ManiacalLabs/AllPixel/ATMega32U4_Arduino_Core/README.md

ATUSB_Core
==========

Modified Arduino Core for ATMega32u4 based on the Teensy core.

Designed for use with the [AllPixel](http://maniacallabs.com/AllPixel). 

Allows for full USB 1.1 speed (12Mbps) when using USB CDC Serial communications.

Currently, there is no functional bootloader for use with this core. An ICSP programmer is required for upload of any code.
