ManiacalLabs/AllPixel/Case/AllPixelCaseBottom.stl

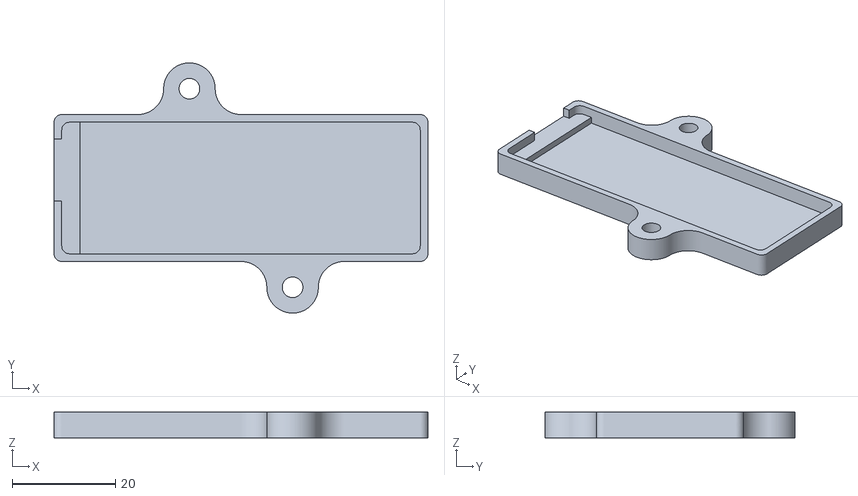
[picture p1: CAD file, 2015-03-14]
Case/AllPixelCaseBottom.stl
72.5 x 48.5 x 5.00
