ManiacalLabs/AllPixel/TinyTiMAllPixelStand/TinyTiMAPStand_noslot.stl

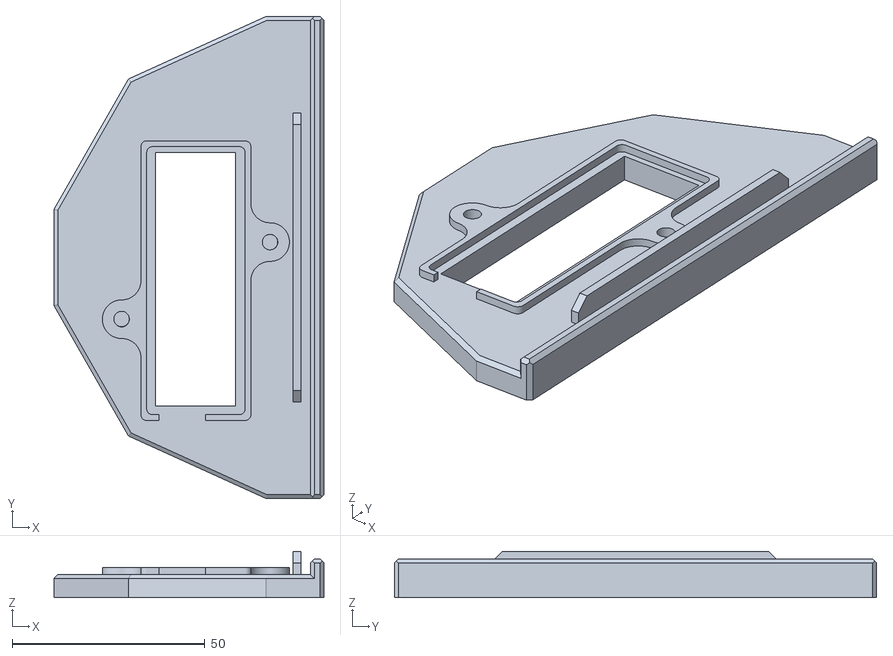
[picture p2: CAD file, 2015-03-22]
TinyTiMAllPixelStand/TinyTiMAPStand_noslot.stl
70.0 x 125.0 x 12.0
