ManiacalLabs/AllPixel/Case/AllPixelCaseTop.stl

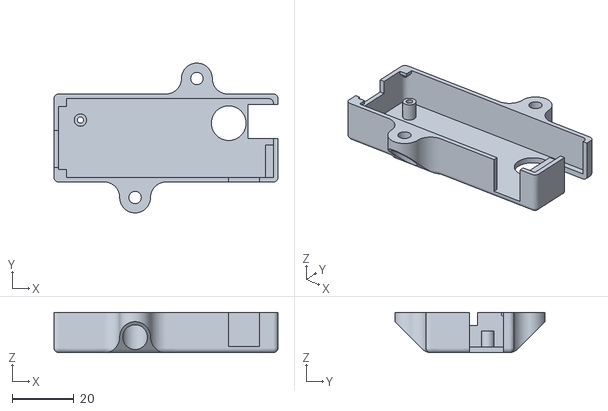
[picture p3: CAD file, 2015-03-14]
Case/AllPixelCaseTop.stl
72.5 x 48.5 x 13.0
