ManiacalLabs/AllPixel/Case/AllPixelCaseTop_NoCapHole.stl

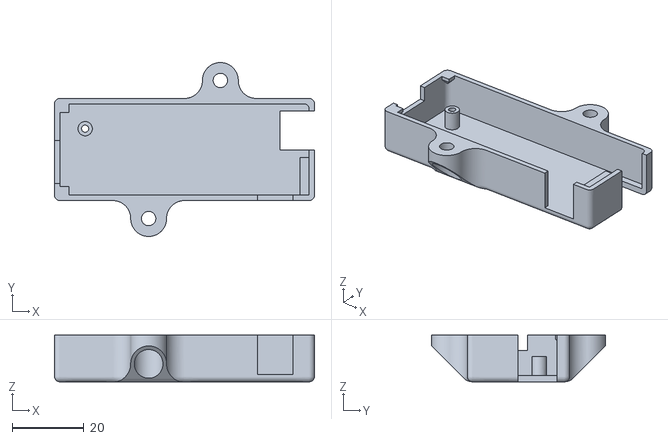
[picture p4: CAD file, 2015-03-14]
Case/AllPixelCaseTop_NoCapHole.stl
72.5 x 48.5 x 13.0
