ManiacalLabs/AllPixel/PCB/AllPixel/AllPixel.pdf

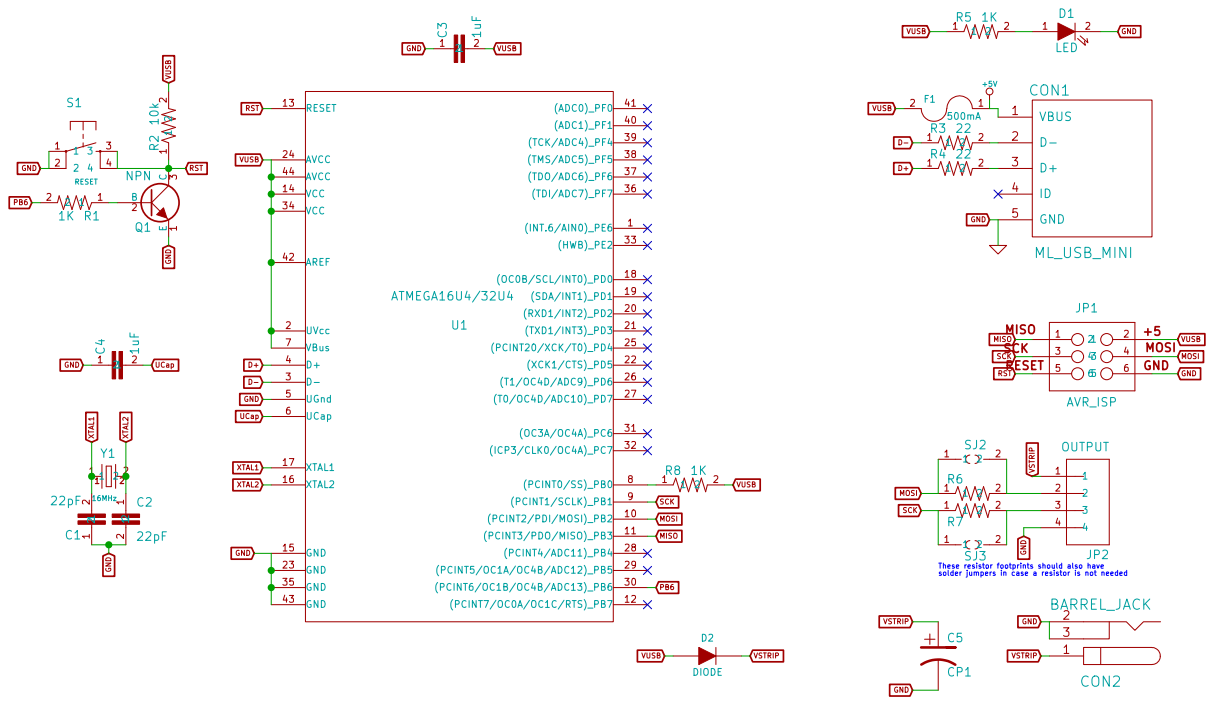
[picture p5: page 1]

These resistor footprints should also have

Id: 1/1 Title: File: AllPixel.sch Sheet: /
