ManiacalLabs/AllPixel/(list of files, drawings)

Other design files:
PCB/AllPixel/AllPixel.dsn
