ManiacalLabs/AllPixel/PCB/AllPixel/PowerTap.kicad_pcb

## KiCad design PCB/AllPixel/PowerTap.kicad_pcb (2015-01-11)

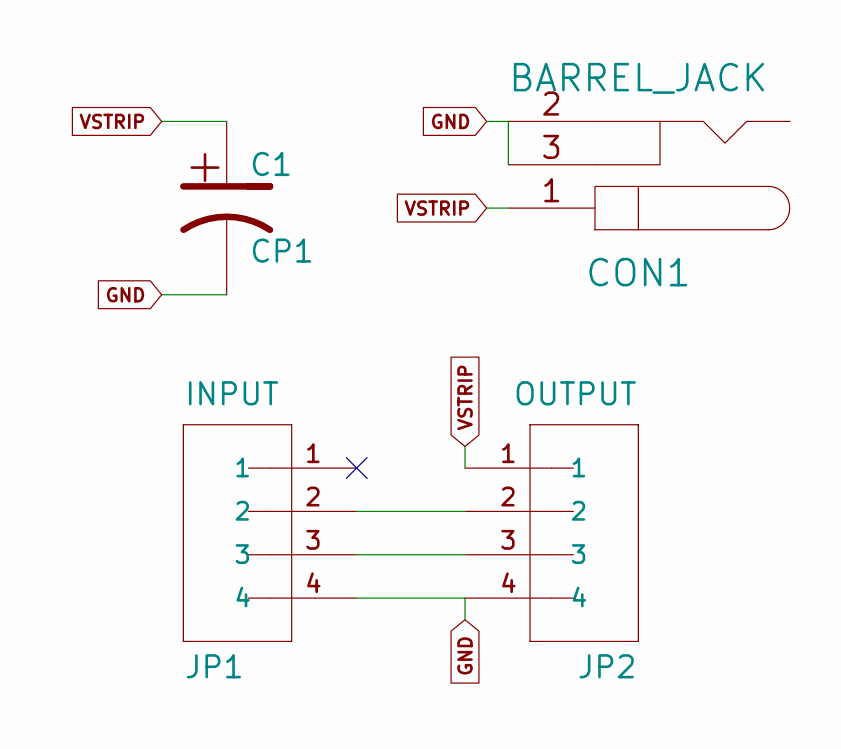
[picture p6: schematic PowerTap.sch]

Parts:
C1: CP1
CON1: BARREL_JACK
JP1: INPUT; SparkFun-1X04_LOCK
JP2: OUTPUT; SparkFun-1X04_LOCK

Connections:
GND: C1.2, CON1.2, CON1.3, JP1.4, JP2.4
unnamed: JP1.2, JP2.2
unnamed: JP1.3, JP2.3
VSTRIP: C1.1, CON1.1, JP2.1

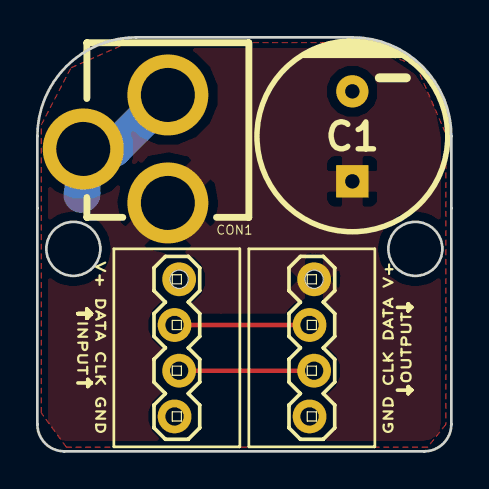
[picture p7: board PowerTap.kicad_pcb from above]

Board: 2 copper layers, 23.0 x 23.0 mm, 4 parts (0 on the bottom side), 4 nets.
