ManiacalLabs/AllPixel/PCB/AllPixelMini/TestJig/PCB/APMTestJig.kicad_pcb

## KiCad design PCB/AllPixelMini/TestJig/PCB/APMTestJig.kicad_pcb (2017-06-18)

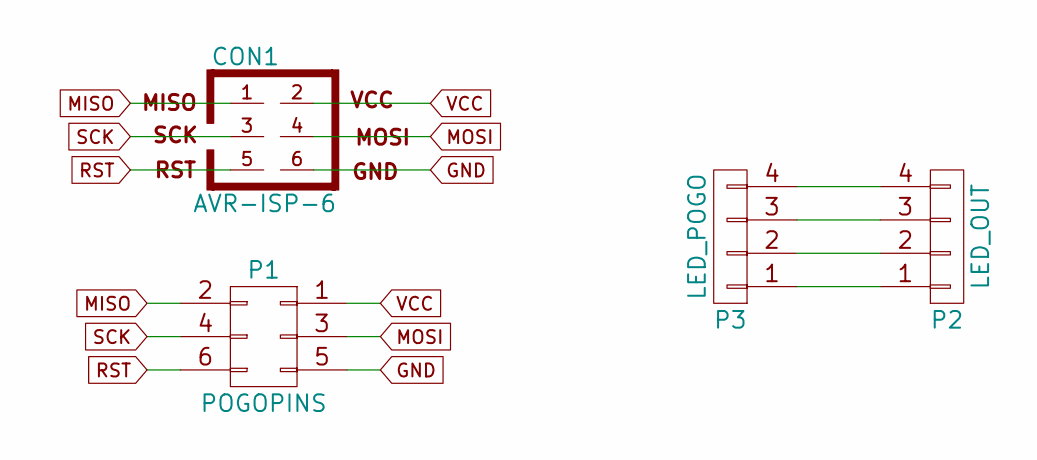
[picture p8: schematic APMTestJig.sch]

Parts:
CON1: AVR-ISP-6; ICSP_1mm097Drill
P1: POGOPINS; ICSP_1mm097Drill
P2: LED_OUT; TerminalBlock_Pheonix_MPT-2.54mm_4pol
P3: LED_POGO; 1x4_1mm097Drill

Connections:
GND: CON1.6, P1.5
MISO: CON1.1, P1.2
MOSI: CON1.4, P1.3
unnamed: P2.1, P3.1
unnamed: P2.2, P3.2
unnamed: P2.3, P3.3
unnamed: P2.4, P3.4
RST: CON1.5, P1.6
SCK: CON1.3, P1.4
VCC: CON1.2, P1.1

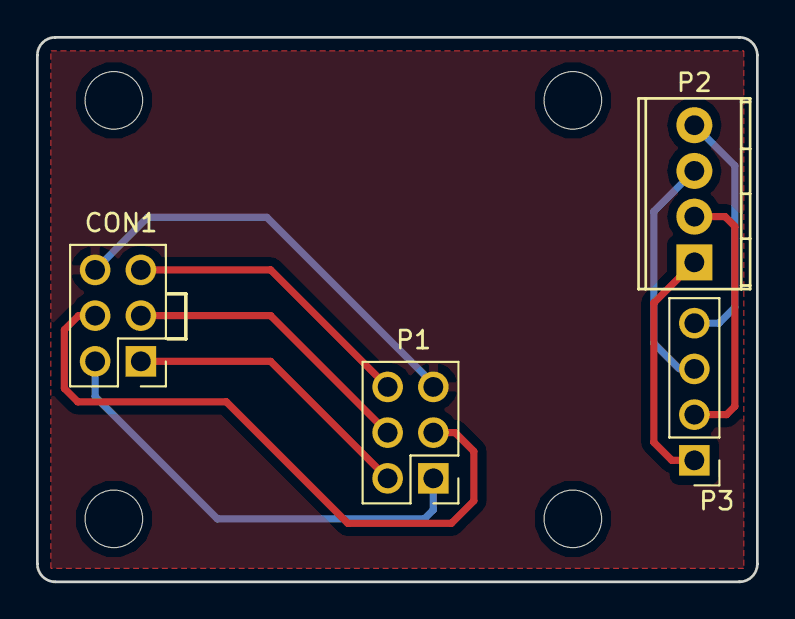
[picture p9: board APMTestJig.kicad_pcb from above]

Board: 2 copper layers, 40.0 x 30.2 mm, 4 parts (0 on the bottom side), 10 nets.
