ManiacalLabs/AllPixel/PCB/AllPixel/AllPixel.kicad_pcb

## KiCad design PCB/AllPixel/AllPixel.kicad_pcb (2015-01-11)

Schematic: AllPixel.sch

Parts:
C1, C2: 22pF; AXIAL-5MM
C3, C4: 1uF; AXIAL-5MM
C5: CP1
CON1: ML_USB_MINI
CON2: BARREL_JACK
D1: LED
D2: DIODE
F1: 500mA
JP1: AVR_ISP; SparkFun-2X3_LOCK
JP2: OUTPUT; SparkFun-1X04_LOCK
Q1: NPN
R1, R5, R8: 1K; R-AXIAL-0.4
R2: 10k; R-AXIAL-0.4
R3, R4: 22; R-AXIAL-0.4
R6, R7: OPT; R-AXIAL-0.4
S1: RESET; SparkFun-TACTILE-PTH
SJ2, SJ3: SOLDERJUMPERNO; SparkFun-SJ_2S-NO
U1: ATMEGA16U4/32U4
Y1: 16MHz; SparkFun-HC49US

Connections:
+5V: CON1.1 (VBUS), F1.1
D+: R4.1, U1.4 (D+)
D-: R3.1, U1.3 (D-)
GND: C1.1, C2.2, C3.1, C4.1, C5.2, CON1.5 (GND), CON2.2, CON2.3, D1.2 (K), JP1.6, JP2.4, Q1.1 (E), S1.1, S1.2, U1.5 (UGnd), U1.15 (GND), U1.23 (GND), U1.35 (GND), U1.43 (GND)
MISO: JP1.1, U1.11 ((PCINT3/PDO/MISO)_PB3)
MOSI: JP1.4, R6.1, SJ2.1, U1.10 ((PCINT2/PDI/MOSI)_PB2)
unnamed: D1.1 (A), R5.2
unnamed: CON1.2 (D-), R3.2
unnamed: CON1.3 (D+), R4.2
unnamed: Q1.2 (B), R1.1
unnamed: JP2.3, R7.2, SJ3.2
unnamed: JP2.2, R6.2, SJ2.2
unnamed: R8.1, U1.8 ((PCINT0/SS)_PB0)
PB6: R1.2, U1.30 ((PCINT6/OC1B/OC4B/ADC13)_PB6)
RST: JP1.5, Q1.3 (C), R2.1, S1.3, S1.4, U1.13 (RESET)
SCK: JP1.3, R7.1, SJ3.1, U1.9 ((PCINT1/SCLK)_PB1)
UCap: C4.2, U1.6 (UCap)
VSTRIP: C5.1, CON2.1, D2.2 (K), JP2.1
VUSB: C3.2, D2.1 (A), F1.2, JP1.2, R2.2, R5.1, R8.2, U1.2 (UVcc), U1.7 (VBus), U1.14 (VCC), U1.24 (AVCC), U1.34 (VCC), U1.42 (AREF), U1.44 (AVCC)
XTAL1: C1.2, U1.17 (XTAL1), Y1.1
XTAL2: C2.1, U1.16 (XTAL2), Y1.2

Notes on the sheet:
These resistor footprints should also have solder jumpers in case a resistor is not needed

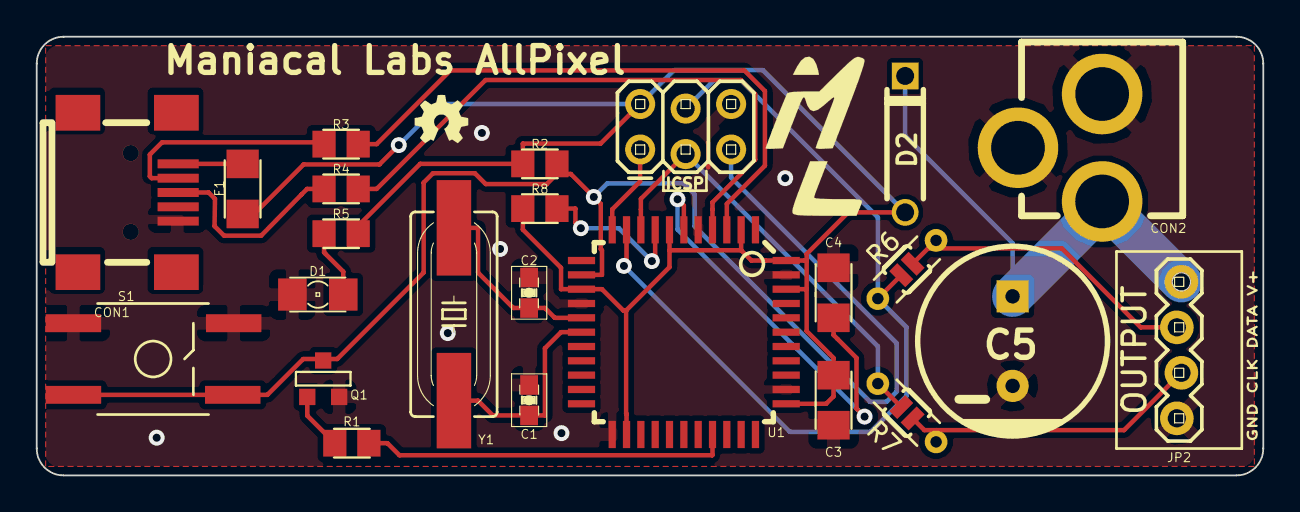
[picture p10: board AllPixel.kicad_pcb from above]

Board: 2 copper layers, 68.5 x 24.5 mm, 27 parts (0 on the bottom side), 21 nets.

Other parts of the board:
Ref**: Val**; ML_LOGO
