ManiacalLabs/AllPixel/PCB/AllPixelMini/PCB/APmini.kicad_pcb

## KiCad design PCB/AllPixelMini/PCB/APmini.kicad_pcb (2017-06-18)

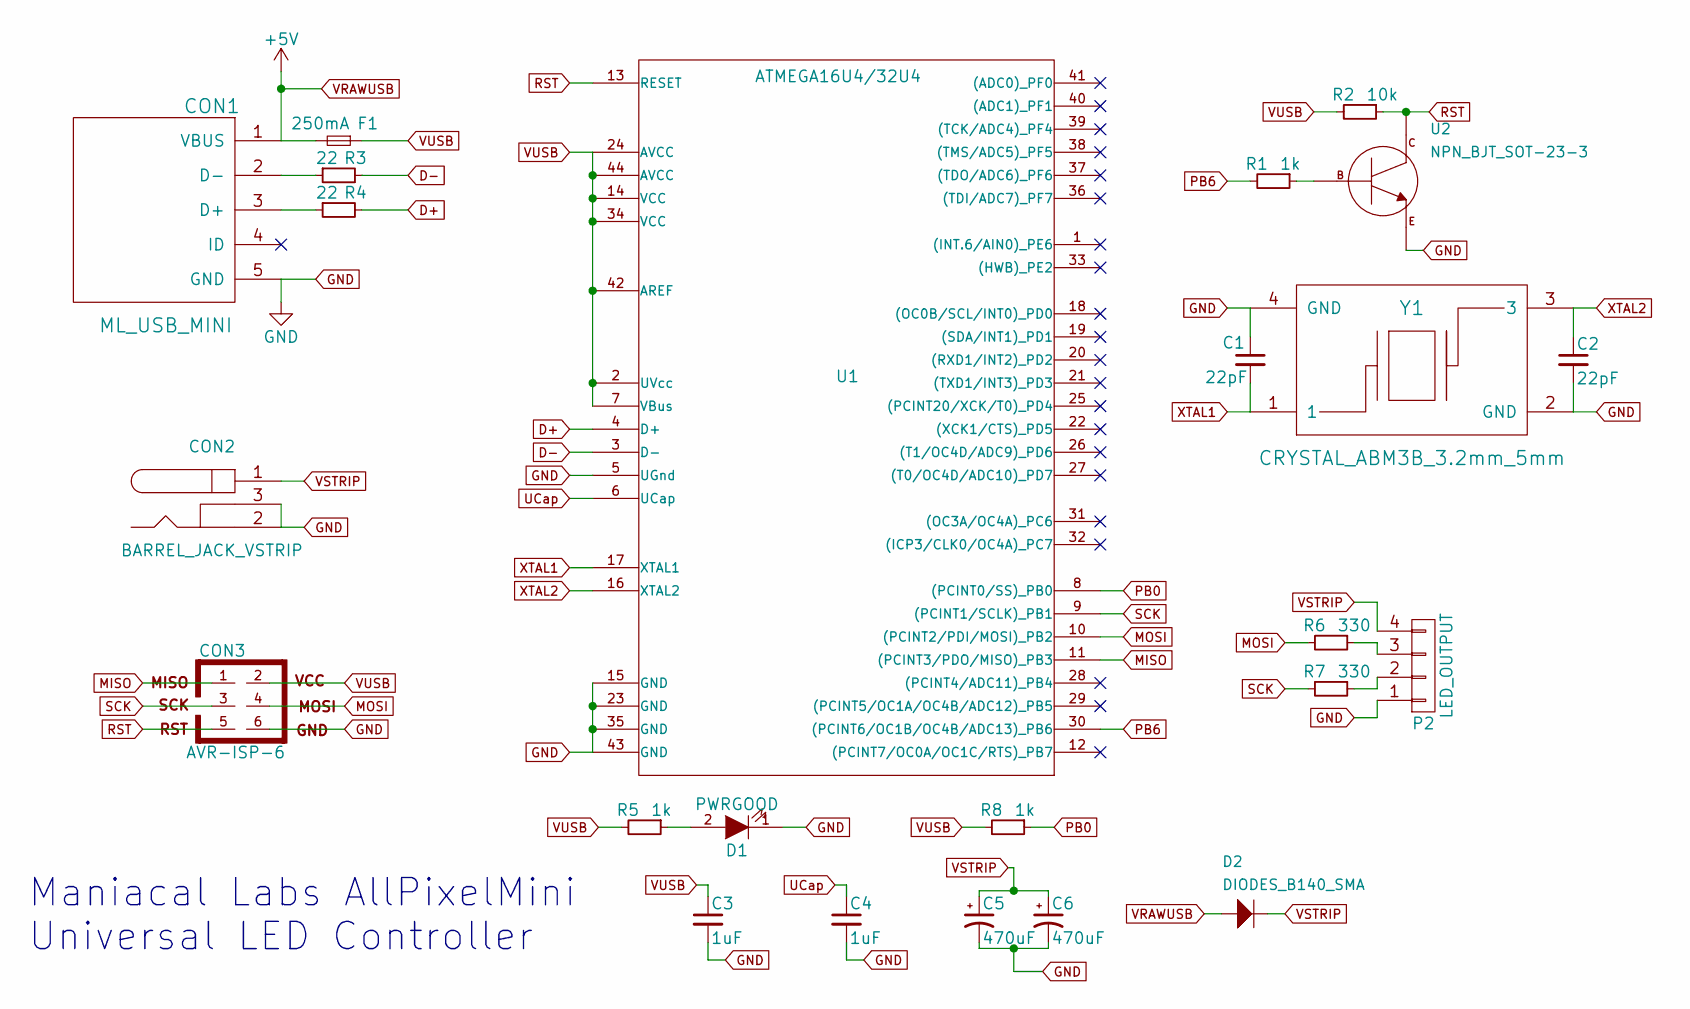
[picture p11: schematic APmini.sch, AllPixelMini]

Parts:
C1, C2: 22pF; C_0603
C3, C4: 1uF; C_0603
C5, C6: 470uF; c_elec_10x10
CON1: ML_USB_MINI; MF_Connectors-MICROUSB-RIGHT
CON2: BARREL_JACK_VSTRIP; ML_BARREL_JACK_ROUND_PADS_SHORT
CON3: AVR-ISP-6; ML_ICSP_PADS
D1: PWRGOOD; LED_0603
D2: DIODES_B140_SMA; MF_Discrete_Semiconductor-SMA
F1: 250mA; C_1206
P2: LED_OUTPUT; TerminalBlock_Pheonix_MPT-2.54mm_4pol
R1, R5, R8: 1k; 0603R_dist_m635
R2: 10k; 0603R_dist_m635
R3, R4: 22; 0603R_dist_m635
R6, R7: 330; 0603R_dist_m635
U1: ATMEGA16U4/32U4; TQFP-44_10x10mm_Pitch0.8mm
U2: NPN_BJT_SOT-23-3; MF_Discrete_Semiconductor-SOT-23-3
Y1: CRYSTAL_ABM3B_3.2mm_5mm; Crystal_ABM3B_3.2mm_5mm

Connections:
D+: R4.2, U1.4 (D+)
D-: R3.2, U1.3 (D-)
GND: C1.1, C2.2, C3.2, C4.2, C5.2, C6.2, CON1.5 (GND), CON2.2, CON2.3, CON3.6, D1.1 (K), P2.1, U1.5 (UGnd), U1.15 (GND), U1.23 (GND), U1.35 (GND), U1.43 (GND), U2.P$2 (EMITTER), Y1.2 (GND), Y1.4 (GND)
MISO: CON3.1, U1.11 ((PCINT3/PDO/MISO)_PB3)
MOSI: CON3.4, R6.2, U1.10 ((PCINT2/PDI/MOSI)_PB2)
unnamed: CON1.2 (D-), R3.1
unnamed: CON1.3 (D+), R4.1
unnamed: D1.2 (A), R5.1
unnamed: P2.2, R7.1
unnamed: P2.3, R6.1
unnamed: R1.1, U2.P$1 (BASE)
PB0: R8.1, U1.8 ((PCINT0/SS)_PB0)
PB6: R1.2, U1.30 ((PCINT6/OC1B/OC4B/ADC13)_PB6)
RST: CON3.5, R2.1, U1.13 (RESET), U2.P$3 (COLLECTOR)
SCK: CON3.3, R7.2, U1.9 ((PCINT1/SCLK)_PB1)
UCap: C4.1, U1.6 (UCap)
VRAWUSB: CON1.1 (VBUS), D2.ANOD (ANODE), F1.2
VSTRIP: C5.1, C6.1, CON2.1, D2.CATH (CATHODE), P2.4
VUSB: C3.1, CON3.2, F1.1, R2.2, R5.2, R8.2, U1.2 (UVcc), U1.7 (VBus), U1.14 (VCC), U1.24 (AVCC), U1.34 (VCC), U1.42 (AREF), U1.44 (AVCC)
XTAL1: C1.2, U1.17 (XTAL1), Y1.1
XTAL2: C2.1, U1.16 (XTAL2), Y1.3

Notes on the sheet:
Maniacal Labs AllPixelMini Universal LED Controller

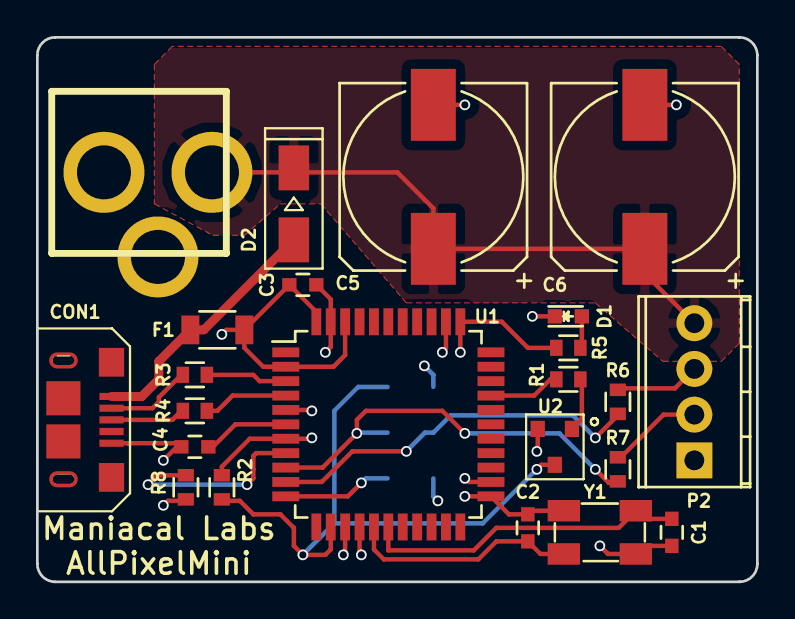
[picture p12: board APmini.kicad_pcb from above]

Board: 4 copper layers, 40.0 x 30.2 mm, 25 parts (1 on the bottom side), 21 nets.

Other parts of the board:
L103: Maniacal Labs; logo_MLlabs
