ManiacalLabs/AllPixel/PCB/AllPixelMini/TestJig/PCB/README

Test Jig Construction:
-Used 3 layers of protoboard to allign the 4 output pogo pins
-Used 2 layers of protoboard to allign the 6 ICSP pad pins
