ManiacalLabs/AllPixel/(threads)

Thread 6 (2015-04-25):

Can you help me out how to use AllPixel with the RBG LED strip!

nikhilrm, 2015-04-25:
Hi,
Can you tell me the procedure of how to use the AllPixel with an RGB LED strip, which also has 4 terminals, for 12V, R,G & B. I would love to use the strip too.

Thanks in advance
Nikhil

adammhaile, 2015-04-25:
Nikhil,

What you are talking about is an analog LED strip but the AllPixel is for
digital strips which have LED driver ICs built in. What you want to do is
not currently possible. If there is enough interest we may release a
product for analog strips as well.

Check the wiki docs for a list of digital strip types that are compatible
with the AllPixel

-Adam
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

adammhaile, 2016-05-18:
Nikhil,

FYI, we have a product for analog LED strips now:
https://www.kickstarter.com/projects/maniacallabs/longpixel-digital-control-for-analog-led-strips/

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

Closed 2015-04-25.

Thread 8 (2017-06-27):

Installation instructions appear to be outdated

drbrain, 2017-06-27:
The AllPixel [Library Install and Strip Example](https://github.com/ManiacalLabs/AllPixel/wiki/Library-Install-and-Strip-Example) instructions say:

> IMPORTANT: Python 2.7.x is REQUIRED. BiblioPixel is NOT 3.x compatible!

But the [BiblioPixel Installation page](https://github.com/ManiacalLabs/BiblioPixel/wiki/Installation) says:

> BiblioPixel v3 requires Python 3.4 or higher

but also mentions a BiblioPixel 2:

> if your application requires Python 2, then there's an unsupported legacy BiblioPixel 2 that works with Python 2.7.

After this using the latest version of BiblioPixel which requires Python 3 the demo program will not run, this appears to be the correct program:

```python
import bibliopixel
# causes frame timing information to be output
bibliopixel.log.setLogLevel(bibliopixel.log.DEBUG)

# Load driver for the AllPixel
from bibliopixel.drivers.serial import *
# set number of pixels & LED type here
driver = Serial(num = 10, type = LEDTYPE.WS2812B)

# load the LEDStrip class
from bibliopixel.layout import *
led = Strip(driver)

# load channel test animation
from bibliopixel.animation import StripChannelTest
anim = StripChannelTest(led)

try:
    # run the animation
    anim.run()
except KeyboardInterrupt:
    # Ctrl+C will exit the animation and turn the LEDs offs
    led.all_off()
    led.update()
```

The update includes consistent indentation and space between comment character and comment to improve readability.

adammhaile, 2017-06-27:
@drbrain - Thanks for pointing that out! BiblioPixel 3.0 has been a huge push to get done and we were still playing catch-up a bit. I'll go through the wiki again now and clean it up.
Thanks for the updated code too! :) Saves me some time.
Will close this out once I've updated everything.

adammhaile, 2017-06-27:
Ok... everything should be updated to reflect BP 3.0. Thanks for pointing that out!

Closed 2017-06-27.

Thread 9 (2018-09-24):

Cannot get AllPixel working

danawoodman, 2018-09-24:
I've followed the directions as closely as I can but still cannot light up my LEDs.

- AllPixelMini
- LEDS: WS2812B
- OSX High Sierra 10.13.6
- Python 3.7.0
- PIP 18.0

Using sample program from Wiki:

```python
import bibliopixel
# causes frame timing information to be output
bibliopixel.log.setLogLevel(bibliopixel.log.DEBUG)

# Load driver for the AllPixel
from bibliopixel.drivers.serial import *
# set number of pixels & LED type here
driver = Serial(num = 10, ledtype = LEDTYPE.WS2812B)

# load the LEDStrip class
from bibliopixel.layout import *
led = Strip(driver)

# load channel test animation
from bibliopixel.animation import StripChannelTest
anim = StripChannelTest(led)

try:
    # run the animation
    anim.run()
except KeyboardInterrupt:
    # Ctrl+C will exit the animation and turn the LEDs offs
    led.all_off()
    led.update()
```

I am getting the following error:

```bash
WARNING - deprecated - util.setLogLevel
INFO - devices - Using COM Port: /dev/cu.usbmodem23451, Device ID: 0, Device Ver: 0
WARNING - deprecated - BaseAnimation.run
DEBUG - animation_threading - Animation starts on main thread
Traceback (most recent call last):
  File "leds.py", line 23, in <module>
    anim.run()
  File "/usr/local/lib/python3.7/site-packages/bibliopixel/animation/animation.py", line 202, in run
    self.start()
  File "/usr/local/lib/python3.7/site-packages/bibliopixel/animation/animation.py", line 108, in start
    self.threading.start()
  File "/usr/local/lib/python3.7/site-packages/bibliopixel/util/threads/animation_threading.py", line 78, in start
    self.target()
  File "/usr/local/lib/python3.7/site-packages/bibliopixel/util/threads/animation_threading.py", line 38, in target
    self.run()
  File "/usr/local/lib/python3.7/site-packages/bibliopixel/animation/animation.py", line 117, in run_all_frames
    for i in self.generate_frames():
  File "/usr/local/lib/python3.7/site-packages/bibliopixel/animation/animation.py", line 121, in generate_frames
    self._pre_run()
  File "/usr/local/lib/python3.7/site-packages/bibliopixel/animation/animation.py", line 171, in _pre_run
    self.runner.run_start_time = self.project.time()
AttributeError: 'NoneType' object has no attribute 'time'
```

Any idea what I could be doing wrong? Something I'm missing?

Thanks!

adammhaile, 2018-09-24:
That's very odd... What's the actual command you are running?

On Sep 23, 2018 11:18 PM, "Dana Woodman" <notifications@github.com> wrote:

I've followed the directions as closely as I can but still cannot light up
my LEDs.

   - AllPixelMini
   - LEDS: WS2812B
   - OSX High Sierra 10.13.6
   - Python 3.7.0
   - PIP 18.0

Using sample program from Wiki:

import bibliopixel# causes frame timing information to be output
bibliopixel.log.setLogLevel(bibliopixel.log.DEBUG)
# Load driver for the AllPixelfrom bibliopixel.drivers.serial import
*# set number of pixels & LED type here
driver = Serial(num = 10, ledtype = LEDTYPE.WS2812B)
# load the LEDStrip classfrom bibliopixel.layout import *
led = Strip(driver)
# load channel test animationfrom bibliopixel.animation import StripChannelTest
anim = StripChannelTest(led)
try:
    # run the animation
    anim.run()except KeyboardInterrupt:
    # Ctrl+C will exit the animation and turn the LEDs offs
    led.all_off()
    led.update()

I am getting the following error:

WARNING - deprecated - util.setLogLevel
INFO - devices - Using COM Port: /dev/cu.usbmodem23451, Device ID: 0,
Device Ver: 0
WARNING - deprecated - BaseAnimation.run
DEBUG - animation_threading - Animation starts on main thread
Traceback (most recent call last):
  File "leds.py", line 23, in <module>
    anim.run()
  File "/usr/local/lib/python3.7/site-packages/bibliopixel/animation/animation.py",
line 202, in run
    self.start()
  File "/usr/local/lib/python3.7/site-packages/bibliopixel/animation/animation.py",
line 108, in start
    self.threading.start()
  File "/usr/local/lib/python3.7/site-packages/bibliopixel/util/threads/animation_threading.py",
line 78, in start
    self.target()
  File "/usr/local/lib/python3.7/site-packages/bibliopixel/util/threads/animation_threading.py",
line 38, in target
    self.run()
  File "/usr/local/lib/python3.7/site-packages/bibliopixel/animation/animation.py",
line 117, in run_all_frames
    for i in self.generate_frames():
  File "/usr/local/lib/python3.7/site-packages/bibliopixel/animation/animation.py",
line 121, in generate_frames
    self._pre_run()
  File "/usr/local/lib/python3.7/site-packages/bibliopixel/animation/animation.py",
line 171, in _pre_run
    self.runner.run_start_time = self.project.time()
AttributeError: 'NoneType' object has no attribute 'time'

Any idea what I could be doing wrong? Something I'm missing?

Thanks!

—
You are receiving this because you are subscribed to this thread.
Reply to this email directly, view it on GitHub
<https://github.com/ManiacalLabs/AllPixel/issues/9>, or mute the thread
<https://github.com/notifications/unsubscribe-auth/AA6a6q8qNFNncHv05TCb3kireI9ssJdiks5ueE8LgaJpZM4W2BH_>
.

danawoodman, 2018-09-24:
`python myfile.py`

danawoodman, 2018-09-24:
FWIW I have the latest BiblioPixel as well `3.4.19`

Closed 2020-10-02.

Thread 10 (2018-11-27):

Can't get AllPixel working on a Pi Zero

xtalker, 2018-11-27:
Tried too many times, install goes ok but just can't get pixels working.  These are WS2811's LED Pixel Digital Diffused 12mm RGB Light P68 Waterproof.

Here are the steps I used to setup the Pi Zero (several times) from scratch:
`Download: 2018-11-13-raspbian-stretch-lite.zip
Use etcher to create SD card with above for a Pi Zero

sudo apt-get update
sudo apt-get dist-upgrade
sudo apt-get install python3-pip
pip3 install pyserial --upgrade --ignore-installed
sudo pip3 install bibliopixel
sudo apt-get install libatlas-base-dev  (fixes "libf77blas.so.3: cannot open shared object file:
   No such  file or directory" error)

strip.py:
	import bibliopixel
	# causes frame timing information to be output
	bibliopixel.log.setLogLevel(bibliopixel.log.DEBUG)

	# Load driver for the AllPixel
	from bibliopixel.drivers.serial import *
	# set number of pixels & LED type here
	driver = Serial(num = 3, ledtype = LEDTYPE.WS2811)

	# load the LEDStrip class
	from bibliopixel.layout import *
	led = Strip(driver)

	# load channel test animation
	from bibliopixel.animation import StripChannelTest
	anim = StripChannelTest(led)

	try:
	    # run the animation
	    anim.run()
	except KeyboardInterrupt:
	    # Ctrl+C will exit the animation and turn the LEDs offs
	    led.all_off()
	    led.update()

pi@raspberrypi:~/allpixel $ python3 strip.py
WARNING - deprecated - util.setLogLevel
INFO - devices - Using COM Port: /dev/ttyACM0, Device ID: 0, Device Ver: 0
WARNING - deprecated - BaseAnimation.run
DEBUG - animation_threading - Animation starts on main thread

(leds do nothing here)`

These leds and Allpixel board work fine on my Mac (running python 2.7) so I've eliminated a hardware issue.

Please help, Xmas is coming!

adammhaile, 2018-11-27:
How are you powering the LEDs?

On Tue, Nov 27, 2018, 3:06 PM Bob Steinbeiser <notifications@github.com
wrote:

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

xtalker, 2018-11-28:
At the moment there are only 9 leds so power is from the Allpixel's USB.  As I mentioned these leds with the same Allpixel work fine on my Mac using Python 2.7

adammhaile, 2018-11-28:
The USB ports on the Raspberry Pi, especially the Zero, are not suitable
for powering LEDs from. They cannot provide enough power. You'll need to
use the barrel jack input on the AllPixel to power the LEDs.

On Wed, Nov 28, 2018 at 8:50 AM Bob Steinbeiser <notifications@github.com>
wrote:

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

xtalker, 2018-11-28:
Hey Adam,  I just tried this with a 5v, 3a external power supply on the Allpixel barrel jack but still no luck.

adammhaile, 2018-11-28:
Just in case, can you set your log level line to this?
`bibliopixel.log.setLogLevel(bibliopixel.log.FRAME)`

I want to make sure that you are actually getting frames written out.
I'm honestly stumped otherwise... a picture of how it's all connected would help. I've never used an AllPixel on a Pi Zero, just a full size Pi.
what's weird is that I would expect if it didn't work that it would show a failure in the script output. But it seems to still be sending data to the AllPixel just fine. That's why I thought it was power.
If you by chance have a regular Pi I recommend trying it with that.... just swap the SD card into the other Pi, it should work.
I'm very suspect of the Pi Zero's weird USB port. Even with external LED power the AllPixel still powers it's microcontroller from the USB connection and I wonder if it's not being powered like it needs to be.

xtalker, 2018-11-28:
Put the same sd card into an rPi2 and made the setLogLevel change you mentioned, still nothing.

`pi@raspberrypi:~/allpixel $ python3 strip.py
WARNING - deprecated - util.setLogLevel
INFO - devices - Using COM Port: /dev/ttyACM0, Device ID: 0, Device Ver: 0
WARNING - deprecated - BaseAnimation.run
DEBUG - animation_threading - Animation starts on main thread`

Does that  device/version ID make sense?  I used this setup  a few years ago (the python 2.7 version) and had no issues at all!

Thanks for your help!
Bob

adammhaile, 2018-11-28:
With that log change it should output a new debug line every ~1 second with
frame timings. If that's not happening then I'd say that it's not actually
sending updates.
Wait.... you said it worked on Mac and I remember you said it was python
2.7 which I dismissed as incorrect because the latest bibliopixel is Python
3 only. Are you using the older BiblioPixel 2 on the Mac?

On Wed, Nov 28, 2018 at 6:00 PM Bob Steinbeiser <notifications@github.com>
wrote:

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

adammhaile, 2018-11-28:
@xtalker - Ah... there's a bit of a regression in the latest couple releases.
Please install v3.4.30
`pip uninstall -y bibliopixel; pip install bibliopixel==3.4.30`

adammhaile, 2018-11-28:
For my own reference, this is related to this: https://github.com/ManiacalLabs/BiblioPixel/issues/1084

xtalker, 2018-11-29:
That fixed it! Works on both the rpi2 & rpi0!
Thanks again!
Bob

Closed 2020-10-02.

Thread 11 (2018-11-29):

Maxtrix.py - Value error: width * height cannot exceed total pixel count!

xtalker, 2018-11-29:
Hey Adam,  I'm trying to get the matrix.py (from https://github.com/ManiacalLabs/AllPixel/wiki/Matrix-Example) working but I get this error:

'Traceback (most recent call last):
  File "matrix.py", line 16, in <module>
    serpentine = True)
  File "/usr/local/lib/python3.5/dist-packages/bibliopixel/layout/matrix.py", line 67, in __init__
    % (self.width, self.height, self.numLEDs))
ValueError: width * height cannot exceed total pixel count! 32 * 32 > 9'

The only line in the example code I changed was:
'driver = Serial(num = 3*3, ledtype = LEDTYPE.WS2812)'
(using a 3x3 Nulsom ns-led-06 led matrix)

Thanks,
Bob

adammhaile, 2018-11-29:
@xtalker Can you submit that here? https://github.com/ManiacalLabs/BiblioPixel/issues
That's really a BiblioPixel issue.
Though you should be able to set `width=3, height=3` in the `Matrix()` creation.
Looks like another slight regression. So sorry about that. It *should* work the way you say but looks like we missed a couple backwards compatibilities.

Closed 2020-10-02.

Thread 12 (2019-01-14):

Can't get AllPixel working with > 500 pixels.

menthon, 2019-01-14:
Hi!

Really enjoying AllPixel Mini and the Accompanying BiblioPixel library. But still can't get the library working with the 700 pixels promised. When initialising driver with more than 500 leds, got the following:

>>> driver = Serial(num = 750, ledtype = LEDTYPE.APA102, c_order = ChannelOrder.BGR)
INFO - devices - Using COM Port: /dev/ttyACM2, Device ID: 0, Device Ver: 0
INFO - driver - Reconfigure and reboot needed!
Waiting for controller to restart...
ERROR - return_codes - 3: Wrong number of pixels for device.
Traceback (most recent call last):
  File "<stdin>", line 1, in <module>
  File "/home/user/.local/lib/python3.6/site-packages/bibliopixel/drivers/serial/driver.py", line 69, in __init__
    raise_error(resp)
  File "/home/user/.local/lib/python3.6/site-packages/bibliopixel/drivers/return_codes.py", line 36, in raise_error
    raise BiblioSerialError(print_error(error))
bibliopixel.drivers.return_codes.BiblioSerialError: None

Anyone got past this?

adammhaile, 2019-01-14:
First glance... you are trying 750 which is definitely not supported.
Second: Please post this over on our support forum: https://groups.google.com/forum/#!forum/maniacal-labs-users
We don't do issue or support tracking here.
Also I expect this to be a BiblioPixel issue.... over on the good group page please post your *complete* code for this so that I can try it out and attempt to debug.

Closed 2020-10-02.

Thread 13 (2019-02-08):

Cannot connect my Allpixel

Wintermute2501, 2019-02-08:
Hey Adam,

I am trying to reactivate my Allpixel.
Running your Strip Example I get the following response:

WARNING - deprecated - util.setLogLevel
INFO - devices - Using COM Port: COM3, Device ID: 0, Device Ver: 0
WARNING - deprecated - BaseAnimation.run
DEBUG - animation_threading - Animation starts on main thread

Can you please help??

BR, Fabian

adammhaile, 2019-02-08:
BTW... support requests should go here -> https://groups.google.com/forum/#!forum/maniacal-labs-users

Was there any more to the console output? That looks like it connected... there's no error. It found the device ID and Version (0 and 0 are correct for a new device). Are you just not getting any output on the LEDs?

What version of bibliopixel are you running? Please send the output of `pip list`

Wintermute2501, 2019-02-08:
Sorry! I did open a topic in Google Groups..

adammhaile, 2019-02-08:
No worries. I need to find a way to make that more clear here.

On Fri, Feb 8, 2019 at 7:23 AM Wintermute2501 <notifications@github.com>
wrote:

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

Closed 2020-10-02.
