ManiacalLabs/AllPixel/Firmware/global.h

#include <EEPROM.h>

#define FIRMWARE_VER 3

template <class T> int EEPROM_writeAnything(int ee, const T& value)
{
	const byte* p = (const byte*)(const void*)&value;
	unsigned int i;
	for (i = 0; i < sizeof(value); i++)
		EEPROM.write(ee++, *p++);
	return i;
}

template <class T> int EEPROM_readAnything(int ee, T& value)
{
	byte* p = (byte*)(void*)&value;
	unsigned int i;
	for (i = 0; i < sizeof(value); i++)
		*p++ = EEPROM.read(ee++);
	return i;
}

#define rebootPin 15
inline void doReboot()
{
	digitalWrite(rebootPin, HIGH);
	while (1);
}

namespace CMDTYPE
{
	enum CMDTYPE
	{
		SETUP_DATA = 1,
		PIXEL_DATA = 2,
		BRIGHTNESS = 3,
		GETID      = 4,
		SETID      = 5,
		GETVER	   = 6
	};
}

namespace RETURN_CODES
{
	enum RETURN_CODES
	{
		SUCCESS = 255,
		REBOOT = 42,
		ERROR = 0,
		ERROR_SIZE = 1,
		ERROR_UNSUPPORTED = 2,
		ERROR_PIXEL_COUNT = 3,
		ERROR_BAD_CMD = 4,
	};
}

#define ONEWIREPIN 2

#define FREE_RAM_BUFFER 180


//#define GENERIC 0
#define LPD8806 1
#define WS2801 2
//NEOPIXEL also known as WS2811, WS2812, WS2812B, APA104
#define NEOPIXEL 3
//400khz variant of above
#define WS2811_400 4
#define TM1809_TM1804 5
#define TM1803 6
#define UCS1903 7
#define SM16716 8
#define APA102 9
#define LPD1886 10
#define P9813 11

struct config_t
{
	uint8_t type;
	uint16_t pixelCount;
	uint8_t spiSpeed;
} config;
#define CONFIGCHECK 7


void writeConfig()
{
	EEPROM_writeAnything(1, config);
}

void readConfig()
{
	EEPROM_readAnything(1, config);
}

void writeDefaultConfig()
{
	config.type = LPD8806;
	config.pixelCount = 1;
	config.spiSpeed = 16;
	writeConfig();
	EEPROM.write(16, 0);
}

uint32_t freeRam()
{
	extern int __heap_start, *__brkval;
	int v;
	return (int)&v - (__brkval == 0 ? (int)&__heap_start : (int)__brkval);
}
