ManiacalLabs/AllPixel/(commit log)

2014-11-09 Added Schematic PDF
2014-12-07 updated silkscreen
    [AllPixel.kicad_pcb]
2014-12-22 added device ID
2015-01-02 Changes to AllPixel PCB for DFM.
    Added USB connector with positioning holes (created new module).
    Flipped fuse to simplify traces.
    Enlarged holes on diode (created new module).
    Replaced Ground fix trace with standard width trace (no longer have
    smaller trace just for that one bodge).
    Cleaned up traces in a few spots to get rid of small, oddly angled
    traces.
    [AllPixel.kicad_pcb]
2015-01-02 More Changes to AllPixel and PowerTap for DFM
    AP: added silk labels for components
    AP: minor trace tweak on USB data pin to avoid right angle
    PT: fixed ground trace too long
    [PowerTap.kicad_pcb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]
2015-01-02 Fixed Crystal footprint not showing reference
    AP: Created new crystal footprint that has the reference on the top of
    the board.
    [AllPixel.kicad_pcb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]
2015-01-03 AP: Added labels to power jack and output pins
    AP: Added labels to power jack and output pins
    PT: Reran gerber file output. Didn't really need to, just to verify.
    [AllPixel.kicad_pcb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]
2015-01-04 fixed silk screen on pads
    [AllPixel.kicad_pcb]
2015-01-04 further fixing of silk screen
    [AllPixel.kicad_pcb]
2015-01-04 fixed jack silk screen on powertap
    [PowerTap.kicad_pcb]
2015-01-04 new top silk gerber
2015-01-04 Adjusted top silk. should be ready for OSHPark
    [AllPixel.kicad_pcb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]
2015-01-09 Modified USB footprint to center anchor.
    AP: Modified USB footprint to center anchor.
    AP: Generated position file for SMD components
    [AllPixel.kicad_pcb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]
2015-02-24 added driver
2015-03-14 Added Case Design
    [AllPixelCaseBottom.stl, AllPixelCaseTop.stl, AllPixelCaseTop_NoCapHole.stl]
2015-03-15 Case top without hole
2015-03-22 Added TinyTim Stand
    Created TinyTiMAllPixelStand folder, added 123D Design file and stl
    export.
    [TinyTiMAPStand_noslot.stl]
2017-01-30 Complete rework for Arduino 1.6 and FastLED 3.1
    [Firmware.ino]
2017-06-18 Moving AP files to AP folder, adding APM files
    [APMTestJig-B.Cu.gbr, APMTestJig-B.Mask.gbr, APMTestJig-B.Paste.gbr, APMTestJig-B.SilkS.gbr, APMTestJig-Edge.Cuts.gbr, APMTestJig-F.Cu.gbr, APMTestJig-F.Mask.gbr, APMTestJig-F.Paste.gbr]
